Richard-V31/16_Store_Enrouleur/StoreEnrouleur_JGB37_DRV8876/DOC/1792562363564_image.png

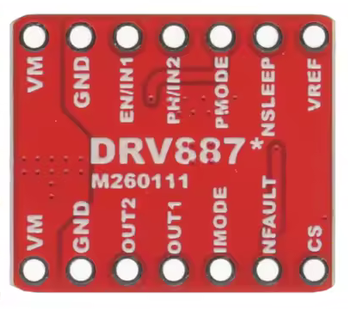
StoreEnrouleur_JGB37_DRV8876/DOC/1792562363564_image.png
