Richard-V31/16_Store_Enrouleur/Version_StoreEnrouleur_multi_ESP/Manuel_utilisation_Stores_v7.4.pdf

Stores enrouleurs v7.4 — Manuel d'utilisation de la page web | Page 1

# Manuel d'utilisation de la page web

Stores enrouleurs — programme v7.4

## 1. Ouvrir la page

Le téléphone ou l'ordinateur doit être connecté au Wi-Fi de la maison. Dans le navigateur, tapez l'adresse de la carte :

Adresse | Page
http://store1.local | Page de la carte « store1 » : ses stores, sa calibration, ses réglages
http://store1.local/tous | Tous les stores de toutes les cartes, sur une seule page
http://store1.local/info | Informations et compteurs de la carte

Remplacez store1 par le nom de votre carte. Si l'adresse en .local ne s'ouvre pas (cas fréquent sous Android), utilisez l'adresse IP de la carte, par exemple http://192.168.1.51. Elle est indiquée sur la page Informations.

Créer une icône sur le téléphone

Ouvrez la page voulue, puis dans le menu du navigateur choisissez « Ajouter à l'écran d'accueil » (Safari : bouton Partager > « Sur l'écran d'accueil »). Le raccourci prend le nom et la couleur de la carte. Conseil : une icône pour la page /tous (usage quotidien), et une par carte pour les réglages.

## 2. La page d'une carte

La page se met à jour seule deux fois par seconde : position, état et barre de progression suivent le store en direct. Sa présentation dépend de la carte : un moteur, deux moteurs indépendants, ou deux moteurs synchronisés.

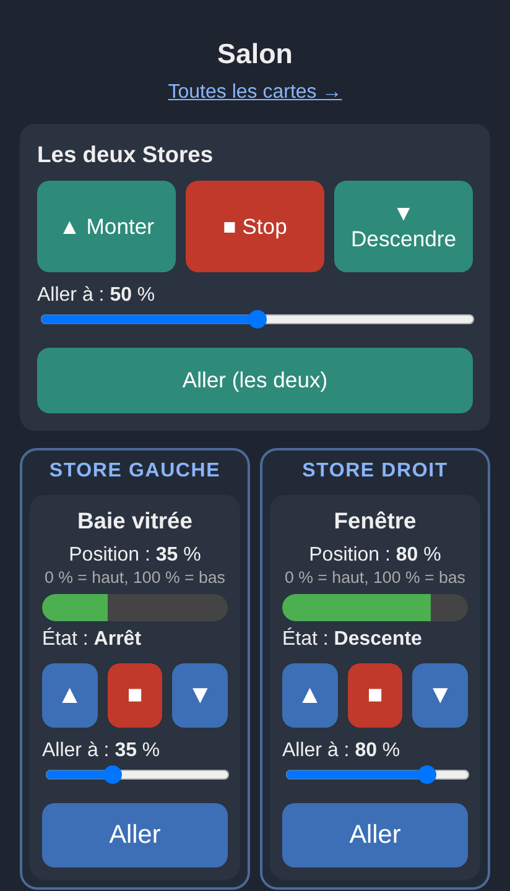
[picture p28: figure]

Stores enrouleurs v7.4 — Manuel d'utilisation de la page web | Page 2

Page d'une carte à deux moteurs indépendants

### 2.1 Le cadre d'un store

Élément | Rôle
Titre du cadre | Emplacement du store (Store Gauche, Store Droit…)
Nom | Nom du store, modifiable dans « Réglage Moteurs »
Position | 0 % = tout en haut, 100 % = tout en bas ; « -- » si le store n'est pas calibré
Barre verte | La même position, en image
État | Arrêt, Montée, Descente — avec « non calibré » ou « calibration en cours » si besoin
▲ (Monter) | Monte jusqu'à ce qu'on appuie sur Stop ou jusqu'à la butée haute
■ (Stop) | Arrêt immédiat
▼ (Descendre) | Descend jusqu'à Stop ou jusqu'à la butée basse
Curseur « Aller à » | Choisit une position, de 0 à 100 %
Aller | Envoie le store à la position du curseur, puis il s'arrête seul

Avec deux moteurs, les deux cadres sont côte à côte et les boutons n'affichent que les symboles ▲ ■ ▼. Avec un seul moteur, le cadre prend toute la largeur et les boutons portent aussi leur texte.

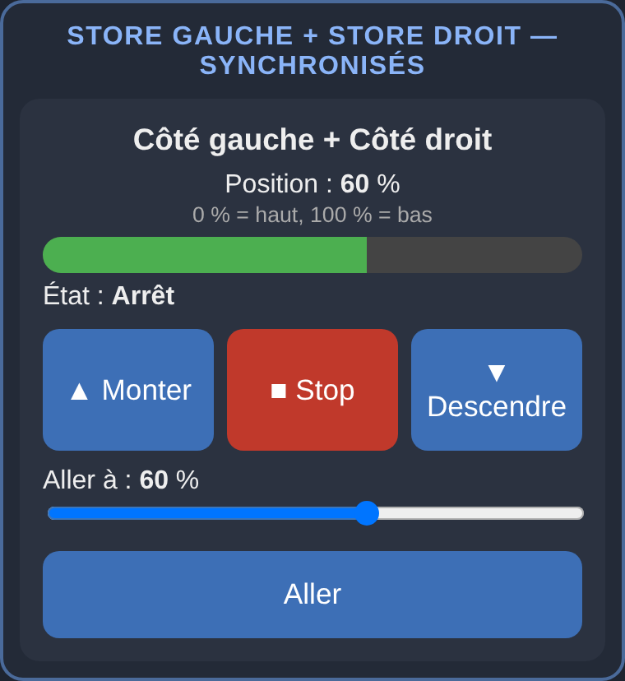
[picture p29: figure]
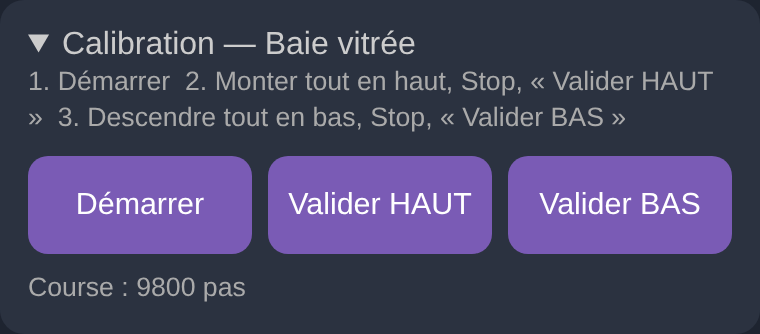
[picture p30: figure]

Stores enrouleurs v7.4 — Manuel d'utilisation de la page web | Page 3

Le moteur démarre doucement et ralentit avant d'arriver : c'est normal. Seul le bouton Stop arrête net.

### 2.2 La carte « Les deux Stores »

Présente seulement avec deux moteurs indépendants. Ses boutons ▲ Monter, ■ Stop, ▼ Descendre et « Aller (les deux) » agissent sur les deux stores à la fois. Si un store refuse (par exemple parce qu'il n'est pas calibré), l'autre obéit quand même et le motif s'affiche en bas de page.

### 2.3 Mode synchronisé

Quand un seul store est entraîné par deux moteurs (un de chaque côté), la page n'affiche qu'un seul cadre, intitulé « … + … — synchronisés ». Les boutons font tourner les deux moteurs ensemble. Le choix du mode est expliqué au chapitre 4.

Mode synchronisé : un seul cadre pour les deux moteurs

## 3. Calibration

La calibration apprend à la carte où sont le haut et le bas du store. Elle est obligatoire avant toute utilisation : sans elle, Monter, Descendre et Aller sont refusés. Elle est conservée après une coupure de courant.

Ouvrez la rubrique « Calibration — nom du store » (un clic sur son titre la déplie). En mode synchronisé, il n'y en a qu'une, marquée « (commune) ».

Rubrique Calibration dépliée

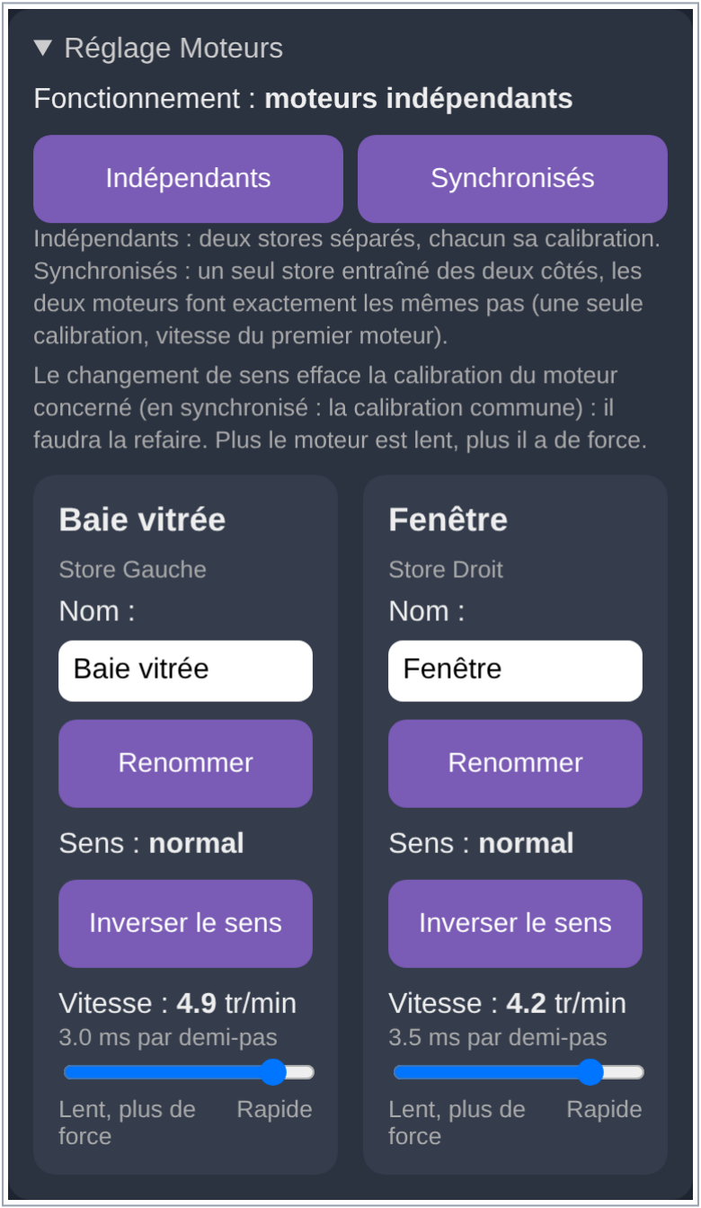
[picture p31: figure]

Stores enrouleurs v7.4 — Manuel d'utilisation de la page web | Page 4
1. Cliquez sur Démarrer. Les butées sont désactivées : le store peut aller partout. Restez attentif.
2. Appuyez sur ▲ pour monter le store. Arrêtez-le avec ■ exactement à la position haute voulue (vous pouvez corriger par petits coups de ▲ / ▼).
3. Cliquez sur Valider HAUT. L'état indique « calibration en cours (haut validé) ».
4. Appuyez sur ▼ pour descendre. Arrêtez-le avec ■ exactement à la position basse voulue.
5. Cliquez sur Valider BAS. La calibration est terminée : l'état revient à « Arrêt », la position affiche 100 % et la ligne « Course » indique le nombre de pas mesuré.

Attention. Pendant la calibration, le moteur ne s'arrête que sur Stop : ne le laissez pas forcer contre une butée mécanique. Les validations sont refusées tant que le moteur tourne.

Quand refaire la calibration ? Après une inversion du sens, après le passage en mode synchronisé, ou si le store s'arrête trop haut ou trop bas (store forcé à la main, glissement).

## 4. Réglage Moteurs

Cliquez sur « Réglage Moteurs » pour déplier la rubrique. Il y a une carte par moteur, plus le choix du mode quand la carte a deux moteurs.

Rubrique Réglage Moteurs dépliée

### 4.1 Nom du store

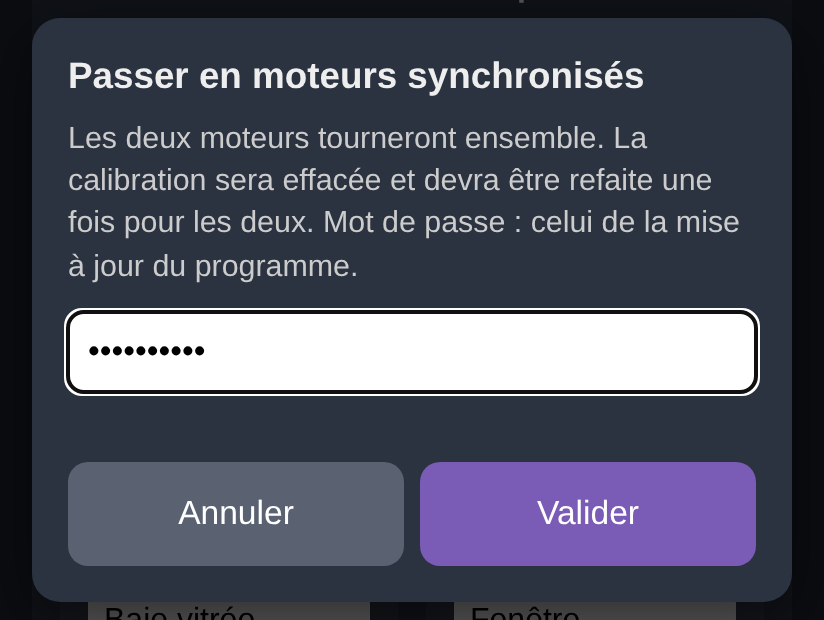
[picture p32: figure]

Stores enrouleurs v7.4 — Manuel d'utilisation de la page web | Page 5

Tapez le nouveau nom dans le champ Nom, puis cliquez sur Renommer. 32 caractères au maximum ; les caractères " \ < > & sont retirés. Un nom vide redonne le nom d'origine. Le nouveau nom apparaît partout, y compris sur la page /tous.

### 4.2 Sens de rotation

Si ▲ fait descendre le store, cliquez sur Inverser le sens et confirmez. La calibration de ce store est effacée (en synchronisé : la calibration commune) : refaites-la ensuite. En synchronisé, chaque moteur a son propre sens : réglez-les pour que les deux côtés tournent dans le même sens.

### 4.3 Vitesse

Le curseur va de « Lent, plus de force » à « Rapide ». Au-dessus s'affichent la vitesse en tours par minute (environ 1,5 à 7,3 tr/min) et la durée d'un demi-pas. La nouvelle vitesse est envoyée quand vous relâchez le curseur, et s'applique même pendant un mouvement. Si un moteur peine ou vibre sans tourner, ralentissez-le : un moteur lent a plus de force.

En synchronisé, seule la vitesse du premier moteur compte ; la carte du second l'indique.

### 4.4 Fonctionnement : indépendants ou synchronisés

Mode | Usage
Indépendants | Deux stores séparés : chacun sa position, sa calibration et sa vitesse
Synchronisés | Un seul store tiré des deux côtés : les deux moteurs font exactement les mêmes pas
1. Cliquez sur le mode voulu (Indépendants ou Synchronisés).
2. Une fenêtre s'ouvre et explique la conséquence. Tapez le mot de passe de mise à jour du programme.
3. Cliquez sur Valider (ou touche Entrée). Annuler ou la touche Échap ferment la fenêtre sans rien changer.

Fenêtre de changement de mode

Si le mot de passe est faux, la fenêtre reste ouverte avec le message « Mot de passe incorrect ». Le mode choisi est conservé après une coupure de courant.

- Passage en synchronisé : la calibration est effacée ; faites une calibration (commune) une fois.
- Retour en indépendants : chaque moteur garde la calibration actuelle.

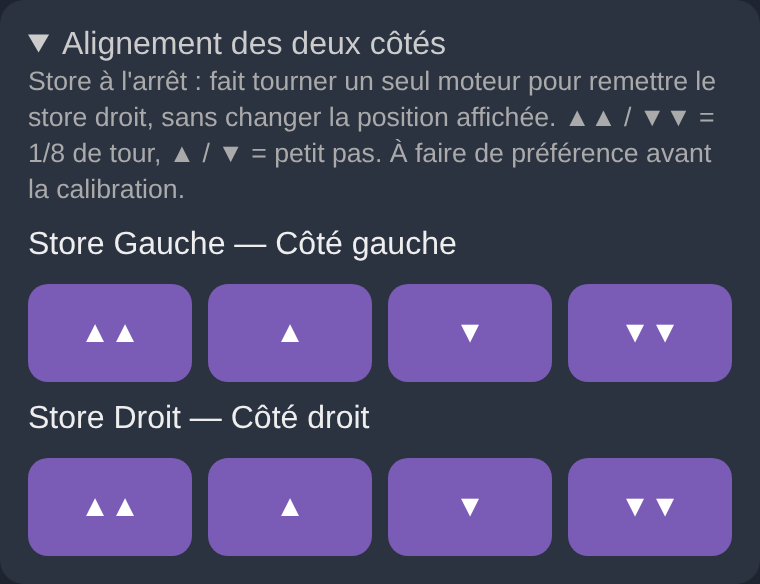
[picture p33: figure]

Stores enrouleurs v7.4 — Manuel d'utilisation de la page web | Page 6

### 4.5 Alignement des deux côtés (synchronisé)

Si le store pend de travers, ouvrez la rubrique « Alignement des deux côtés ». Store à l'arrêt, chaque bouton fait tourner un seul moteur, lentement, sans changer la position affichée :

Bouton | Déplacement de ce côté
▲▲ / ▼▼ | 1/8 de tour vers le haut / le bas
▲ / ▼ | Petit pas (1/64 de tour)

Rubrique Alignement (mode synchronisé)

Les appuis s'additionnent (un tour au maximum). L'état affiche « Alignement en cours » pendant le mouvement. Faites l'alignement de préférence avant la calibration. Tout mouvement du store annule un alignement en attente.

## 5. La page « Toutes les cartes » (/tous)

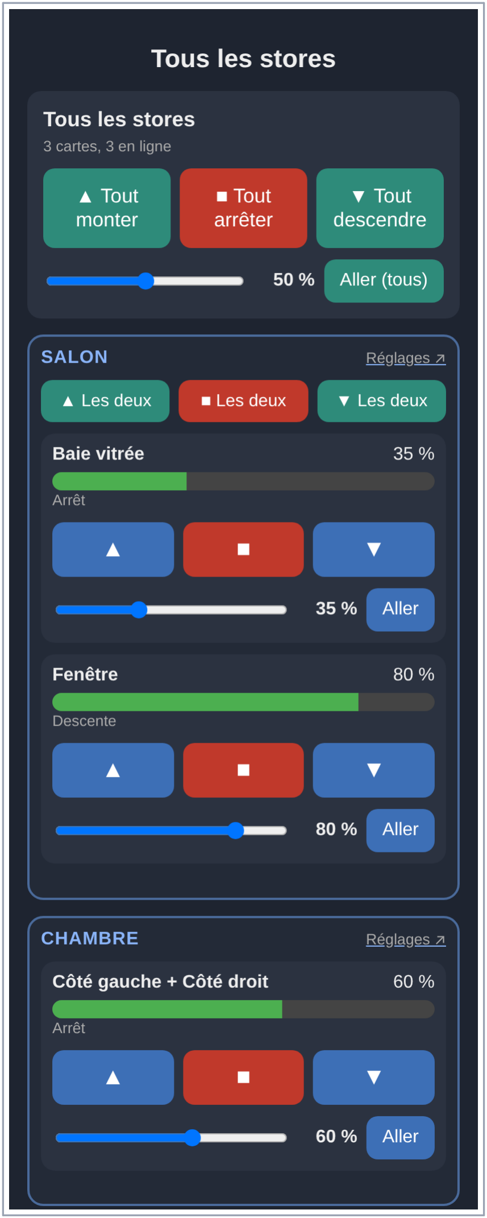
[picture p34: figure]

Stores enrouleurs v7.4 — Manuel d'utilisation de la page web | Page 7

Page « Toutes les cartes » avec trois cartes (Salon, Chambre en synchronisé, Bureau non calibré)

Accessible depuis n'importe quelle carte (lien « Toutes les cartes → » en haut de sa page). Elle réunit tous les stores de la maison. Les autres cartes apparaissent toutes seules dans les 30 secondes ; le compteur en haut indique combien de cartes sont trouvées et combien sont en ligne.

### 5.1 Tous les stores

Bouton | Effet
▲ Tout monter | Monte tous les stores de toutes les cartes
■ Tout arrêter | Arrête tout (envoyé aussi aux cartes qui ne répondent plus)
▼ Tout descendre | Descend tous les stores
Curseur + Aller (tous) | Envoie tous les stores à la même position

### 5.2 Le cadre de chaque carte

- Titre de la carte (son nom de pièce) et lien Réglages ↗, qui ouvre la page de cette carte pour la calibration et les réglages.
- Boutons « Les deux » (▲ ■ ▼) si la carte a deux stores indépendants.
- Pour chaque store : nom, position, barre, état, boutons ▲ ■ ▼, curseur et bouton Aller.
- Un refus éventuel (store non calibré…) s'affiche en orange sous le cadre.

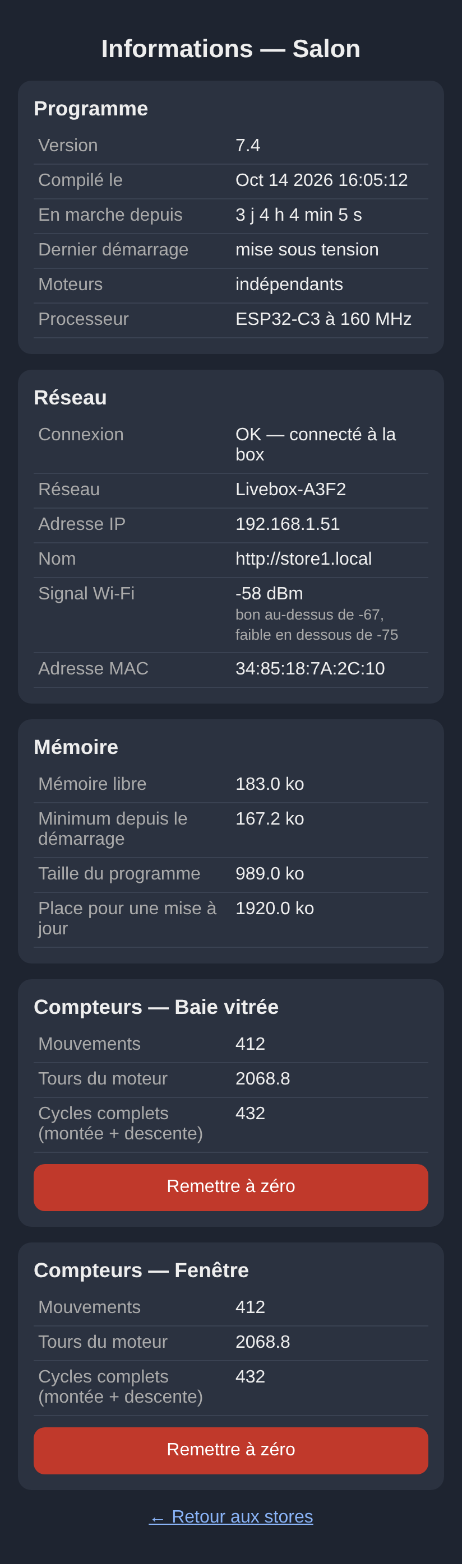
[picture p35: figure]

Stores enrouleurs v7.4 — Manuel d'utilisation de la page web | Page 8
- Une carte qui ne répond plus devient grisée, avec « Carte injoignable ». Elle redevient normale dès qu'elle répond.

La page /tous ne permet ni la calibration ni les réglages : utilisez le lien Réglages ↗.

## 6. Page Informations (/info)

Accessible par le lien Informations en bas des pages. Rafraîchie toutes les 2 secondes.

Page Informations

Carte | Contenu
Programme | Version, date de compilation, durée de fonctionnement, cause du dernier démarrage, mode des moteurs, processeur
Réseau | État de la connexion, réseau, adresse IP, nom .local, force du signal Wi-Fi, adresse MAC
Mémoire | Mémoire libre, minimum atteint, taille du programme, place pour une mise à jour
Compteurs | Par store : mouvements, tours du moteur, cycles complets (montée + descente)

Signal Wi-Fi : bon au-dessus de −67 dBm, faible en dessous de −75 dBm. Le bouton Remettre à zéro (avec confirmation) remet les compteurs d'un store à zéro, par exemple après un changement de moteur.

## 7. Mise à jour du programme (/update)

Stores enrouleurs v7.4 — Manuel d'utilisation de la page web | Page 9
1. Dans l'Arduino IDE : Croquis > Exporter les binaires compilés.
2. Ouvrez la page Mise à jour du programme (lien en bas de la page de la carte).
3. Tapez le mot de passe OTA, choisissez le fichier .ino.bin du croquis (pas « merged », pas « bootloader »), puis cliquez sur Envoyer.
4. La barre montre l'envoi. À la fin, la carte redémarre et la page principale revient seule au bout de 10 secondes.

Les moteurs sont arrêtés pendant la mise à jour ; positions, calibration et réglages sont conservés. Envoyez toujours un fichier compilé pour le même modèle de carte (C3 ou S3).

## 8. Mode secours (sans la box)

Si la carte ne trouve pas la box à son démarrage (box éteinte, coupure de courant), elle crée son propre réseau Wi-Fi, par exemple « Store1-Secours ».

1. Sur le téléphone, connectez-vous à ce réseau (mot de passe : celui du réseau de secours).
2. Ouvrez http://192.168.5.1 : la page de la carte fonctionne normalement.

Toutes les 2 minutes, la carte essaie de retrouver la box (sauf pendant qu'un téléphone est connecté à son réseau de secours) et y retourne seule dès qu'elle répond. En mode secours, la page /tous ne montre que cette carte.

## 9. Messages

Les messages apparaissent en bas de la page (en orange sous le cadre de la carte sur /tous).

Message | Signification | Que faire
non calibré : lancez d'abord la calibration | Store jamais calibré | Faire la calibration (chapitre 3)
non calibré ou calibration en cours | « Aller » impossible pour l'instant | Terminer la calibration
cliquez d'abord sur « Démarrer » | Validation sans calibration commencée | Cliquer sur Démarrer
validez d'abord la position haute | « Valider BAS » trop tôt | Valider le haut d'abord
arrêtez le moteur avant de valider | Le moteur tourne | Appuyer sur Stop, puis valider
descendez le store avant de valider le bas | Position basse = position haute | Descendre le store
arrêtez le store avant d'aligner | Alignement pendant un mouvement | Stop, puis aligner
Mise à jour en cours, patientez | Programme en cours d'écriture | Attendre le redémarrage
Mot de passe incorrect : mode inchangé | Changement de mode refusé | Mot de passe de mise à jour
Carte injoignable | La carte ne répond pas | Vérifier son alimentation et le Wi-Fi
Moteurs synchronisés : faites la calibration… | Mode changé | Faire la calibration commune
… : sens inversé, refaites sa calibration | Sens changé | Refaire la calibration

Stores enrouleurs v7.4 — Manuel d'utilisation de la page web | Page 10

## 10. Questions fréquentes

Le store s'arrête un peu avant ou après le bon endroit. La position est calculée en comptant les pas ; un glissement ou une manœuvre à la main la décale. Refaites la calibration.

Une coupure de courant pendant un mouvement ? La position est enregistrée pendant le mouvement : au redémarrage, l'écart reste faible. Vérifiez par un aller jusqu'en haut ; recalibrez si le décalage gêne.

Deux personnes commandent en même temps ? Possible : la dernière commande reçue l'emporte. Toutes les pages ouvertes affichent le même état.

Une carte manque sur la page /tous. Attendez 30 secondes et rechargez la page. Si elle n'apparaît toujours pas, ouvrez-la directement par son adresse pour vérifier qu'elle fonctionne, puis voyez la notice technique (adresses fixes FIXED_PEERS).
