Richard-V31/16_Store_Enrouleur/PCB/BOTTOM.JPG

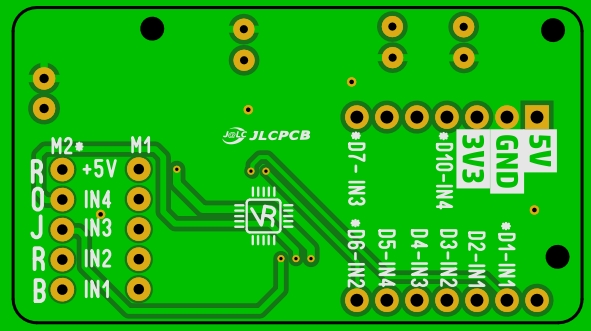
PCB/BOTTOM.JPG
