Richard-V31/16_Store_Enrouleur/PCB/PCB.JPG

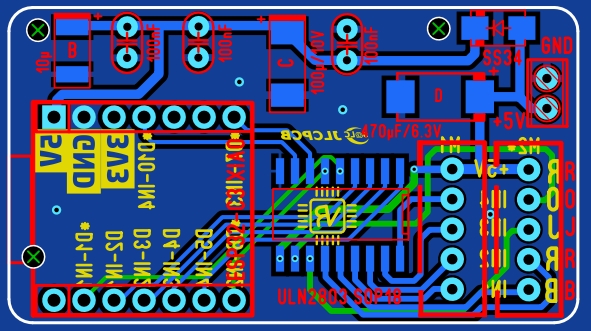
PCB/PCB.JPG
