Richard-V31/16_Store_Enrouleur/PCB/TOP.JPG

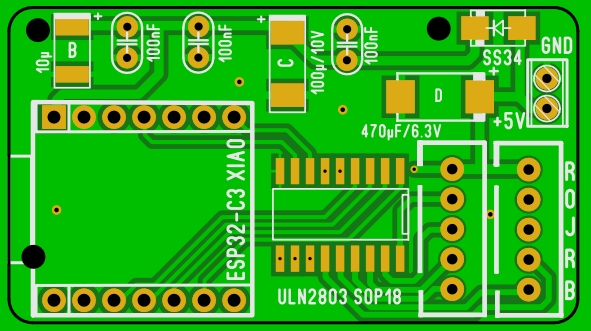
PCB/TOP.JPG
