Richard-V31/16_Store_Enrouleur/PCB/VERSION_DOUBLE/BOTTOM DOUBLE.JPG

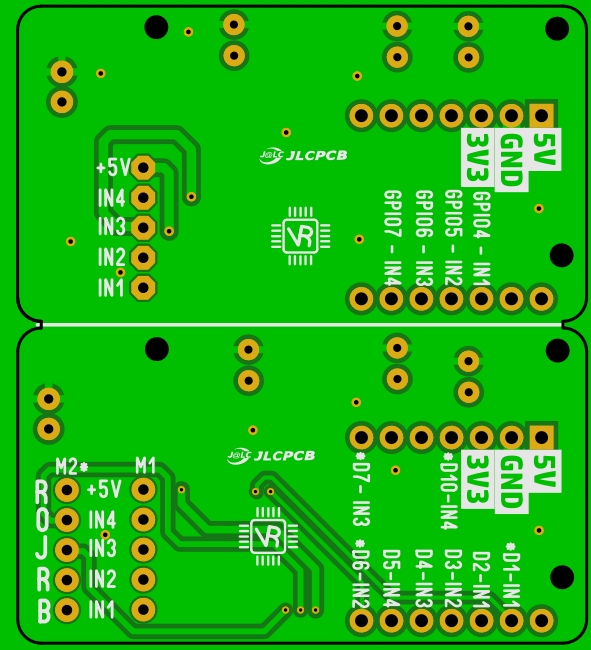
PCB/VERSION_DOUBLE/BOTTOM DOUBLE.JPG
