Richard-V31/16_Store_Enrouleur/PCB/VERSION_DOUBLE/PCB DOUBLE.JPG

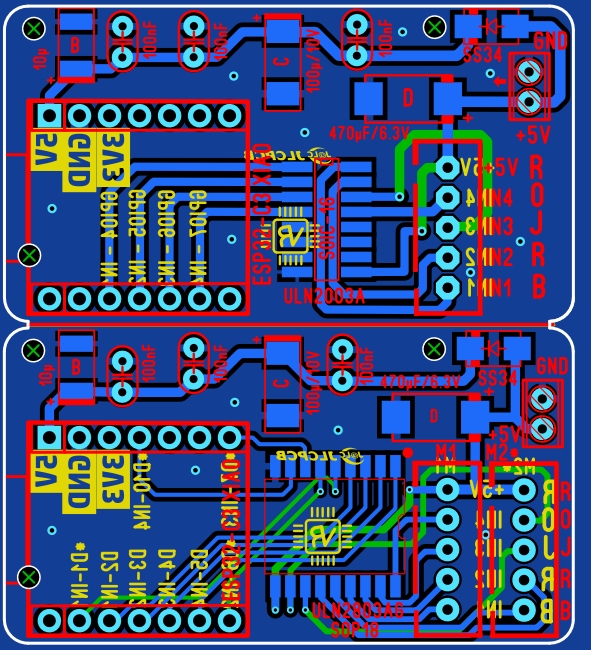
PCB/VERSION_DOUBLE/PCB DOUBLE.JPG
