Richard-V31/16_Store_Enrouleur/StoreEnrouleur_JGB37_DRV8876/DOC/DRV8876.jpg

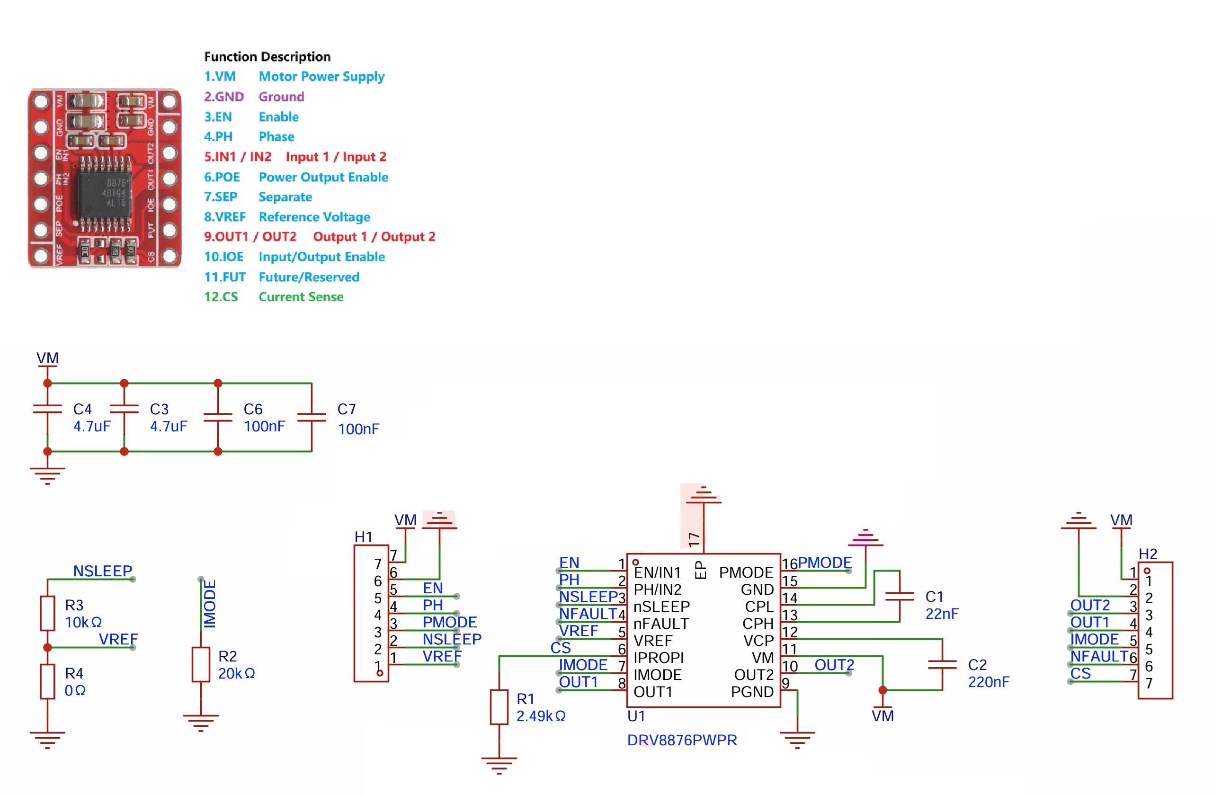
StoreEnrouleur_JGB37_DRV8876/DOC/DRV8876.jpg
