Richard-V31/16_Store_Enrouleur/StoreEnrouleur_JGB37_DRV8876/DOC/Moteur/JGB37 520  2.png

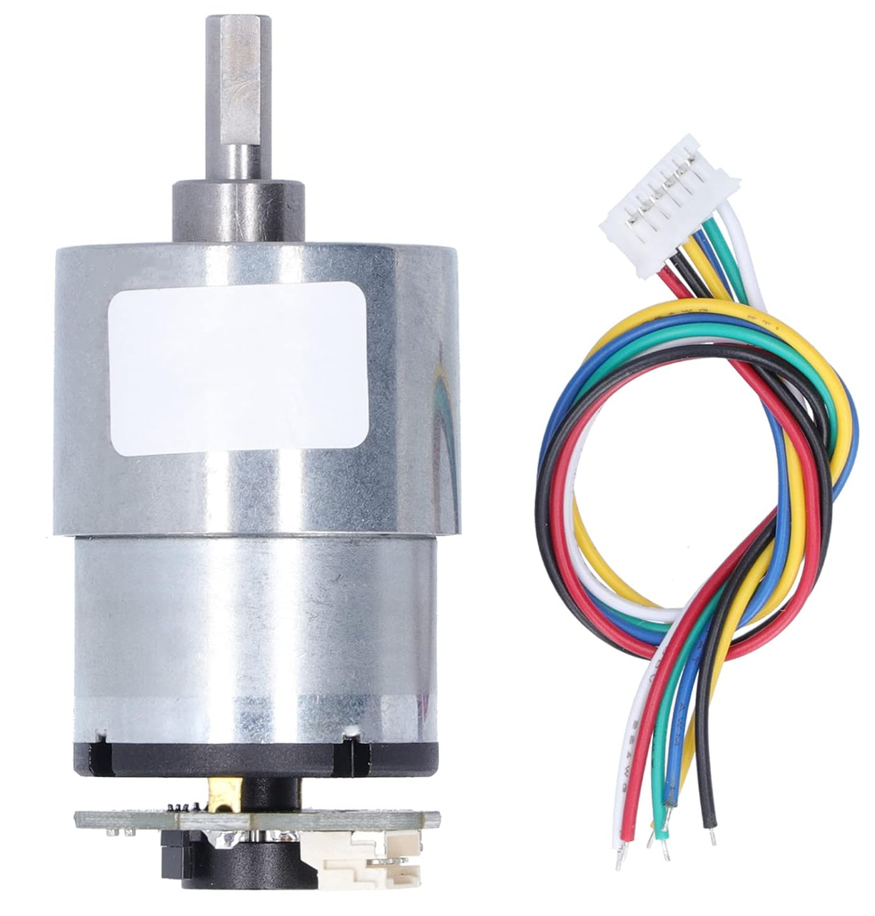
StoreEnrouleur_JGB37_DRV8876/DOC/Moteur/JGB37 520 2.png
