Richard-V31/16_Store_Enrouleur/Version_StoreEnrouleur_multi_ESP/Capture ecran.png

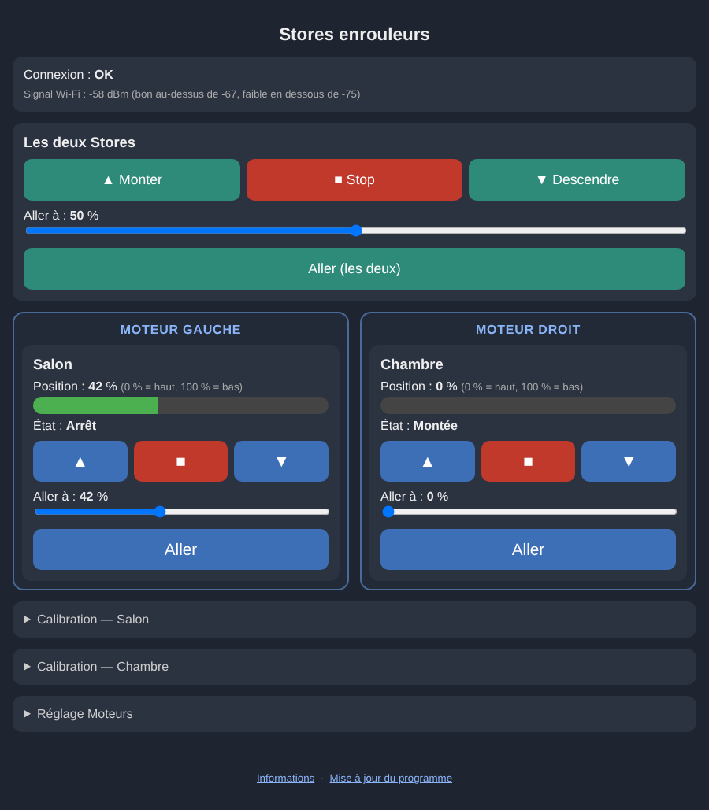
Version_StoreEnrouleur_multi_ESP/Capture ecran.png
