Richard-V31/16_Store_Enrouleur/StoreEnrouleur_JGB37_DRV8876/DOC/Choix_vitesse_JGB37-520.xlsx

Choix de la vitesse du motoréducteur JGB37-520 12 V — store enrouleur
Cellules jaunes à texte bleu = hypothèses à modifier ; le reste se recalcule.
Hypothèses
Diamètre du tube (mm) | 35 | Tube de store (valeur de la fiche technique)
Hauteur de toile à enrouler (mm) | 1500 | À adapter à ton store
Couple nécessaire au store (kg·cm) | 1.6 | Fiche technique : 1,58 kg·cm pour un store de 900 g sur tube de 35 mm
Couple nominal de référence (kg·cm) | 8.4 | Fiche technique : JGB37-520 12 V, réducteur 1:270, en charge nominale
Rapport de référence (1:x) | 270 | Rapport correspondant au couple de référence
Impulsions encodeur par tour moteur | 11 | Fiche technique : encodeur à effet Hall, 11 impulsions/tour
Temps de course maximal acceptable (s) | 35 | Au-delà : jugé trop lent
Marge de couple conseillée (×) | 4 | Couple nominal / couple nécessaire pour « meilleur compromis »
Marge de couple minimale (×) | 2.5 | En dessous : à éviter
Comparaison des versions
Vitesse (tr/min) | Réducteur (1:x) | Vitesse de la toile (mm/s) | Temps pour la hauteur (s) | Couple nominal estimé (kg·cm) | Marge de couple (×) | Impulsions par tour de tube | Avis
20 | 1:506.0 | 36.65191429 | 40.9 | 15.7 | 9.8× | 22264 | Trop lent, inutile
37 | 1:270.0 | 67.80604144 | 22.1 | 8.4 | 5.2× | 11880 | Le meilleur compromis
60 | 1:168.0 | 109.9557429 | 13.6 | 5.2 | 3.3× | 7392 | Possible si tu veux plus rapide
111 | 1:90.0 | 203.4181243 | 7.4 | 2.8 | 1.8× | 3960 | À éviter : marge trop faible
178 | 1:56.0 | 326.2020372 | 4.6 | 1.7 | 1.1× | 2464 | À éviter : marge trop faible
333 | 1:30.0 | 610.254373 | 2.5 | 0.9 | 0.6× | 1320 | À éviter : marge trop faible
530 | 1:19.0 | 971.2757287 | 1.5 | 0.6 | 0.4× | 836 | À éviter : marge trop faible
1000 | 1:10.0 | 1832.595715 | 0.8 | 0.3 | 0.2× | 440 | À éviter : marge trop faible
1590 | 1:6.3 | 2913.827186 | 0.5 | 0.2 | 0.1× | 277.2 | À éviter : marge trop faible
Notes
• Couple estimé proportionnellement au rapport de réduction, à partir de 8,4 kg·cm au 1:270 (fiche technique). Le rendement réel du réducteur et sa limite mécanique ne sont pas pris en compte : aux grands rapports (1:506), le couple réel est plafonné par le réducteur.
• Le couple nécessaire augmente quand la toile s'enroule (diamètre qui grossit), avec le frottement des coulisses et l'usure : d'où une marge conseillée d'environ 4×.
• Les grands rapports (1:270, 1:168) sont presque irréversibles : hors tension, le poids de la toile ne fait pas tourner le moteur et la position mémorisée reste juste. En dessous de 1:90, le store risque de glisser après une coupure.
• Avec la limitation de courant du DRV8876 (≈ 1,3 A), un moteur moins démultiplié se rapproche plus vite de la limite pour la même charge.
• Programme v6 : aucune modification quelle que soit la vitesse ; la course est mesurée à la calibration.
