Richard-V31/16_Store_Enrouleur/STL/BlindGear_V5_27mm_PCBWay Community.stl

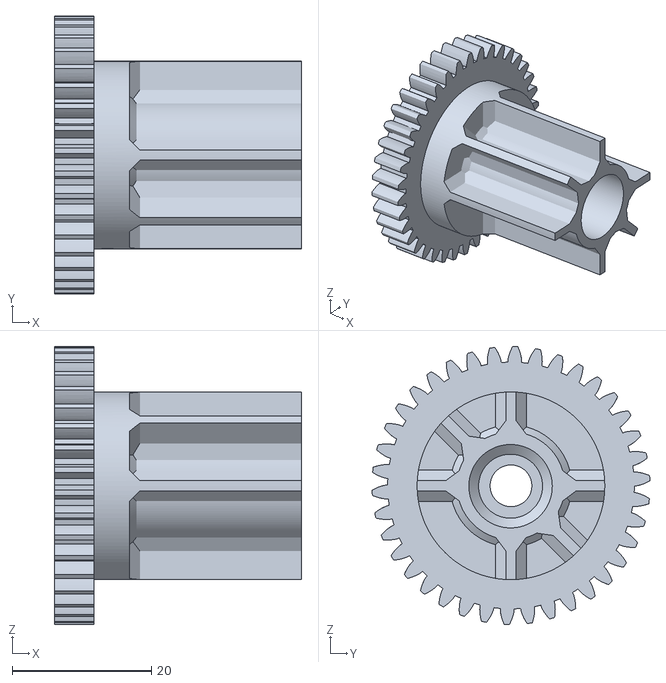
[picture p58: CAD file, 2026-10-30]
STL/BlindGear_V5_27mm_PCBWay Community.stl
35.6 x 40.0 x 40.0
