Richard-V31/16_Store_Enrouleur/STL/Fusion360/Pignon.stl

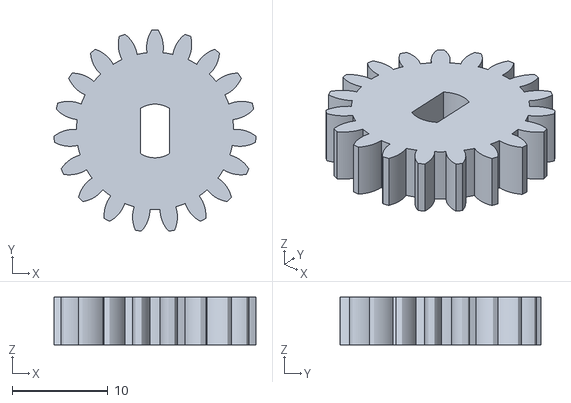
[picture p59: CAD file, 2026-10-31]
STL/Fusion360/Pignon.stl
21.1 x 21.0 x 5.00
