Richard-V31/16_Store_Enrouleur/STL/Circuit_Encloser_V3_PCBWay Community.stl

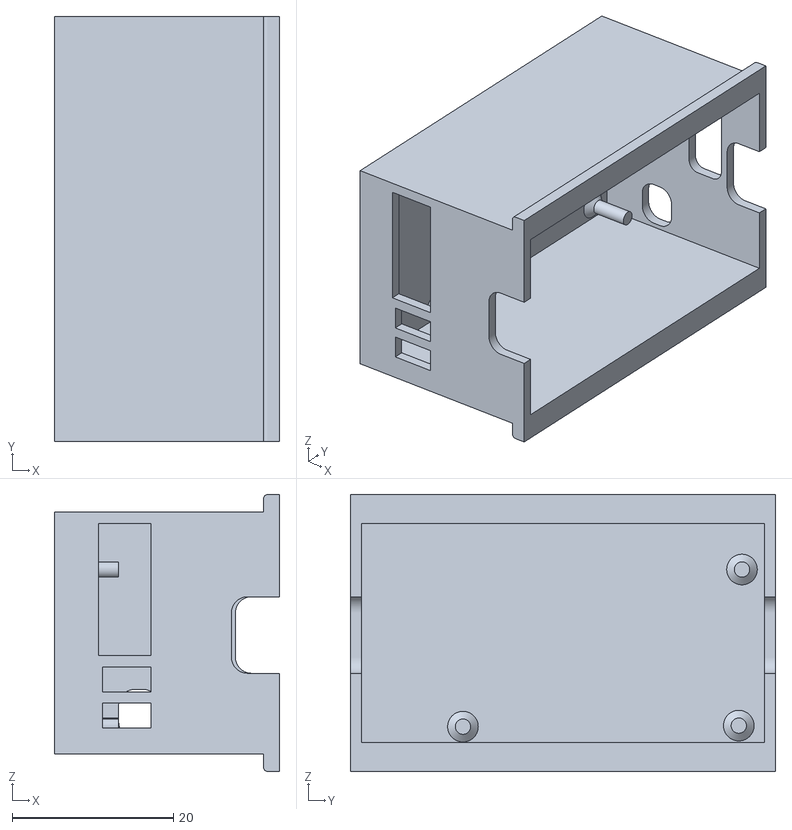
[picture p60: CAD file, 2026-10-30]
STL/Circuit_Encloser_V3_PCBWay Community.stl
28.0 x 52.8 x 34.4
