Richard-V31/16_Store_Enrouleur/STL/Fusion360/Roue_Store.stl

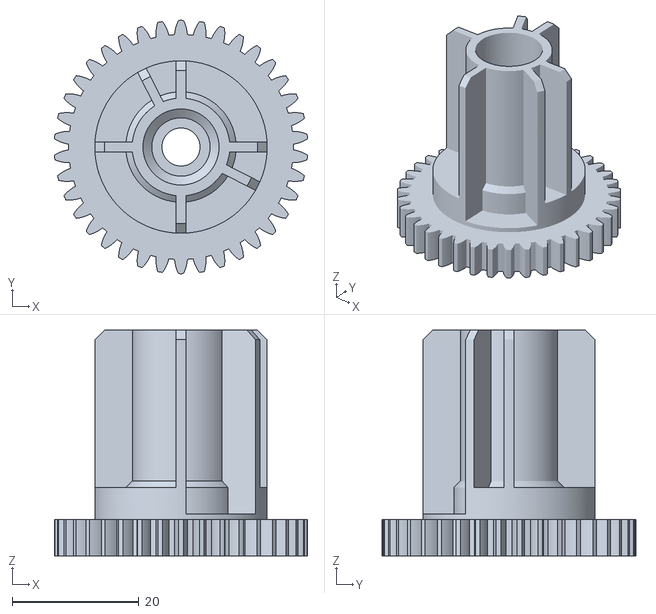
[picture p61: CAD file, 2026-10-31]
STL/Fusion360/Roue_Store.stl
39.9 x 40.0 x 35.6
