Richard-V31/16_Store_Enrouleur/STL/GearEncloser_V2_PCBWay Community.stl

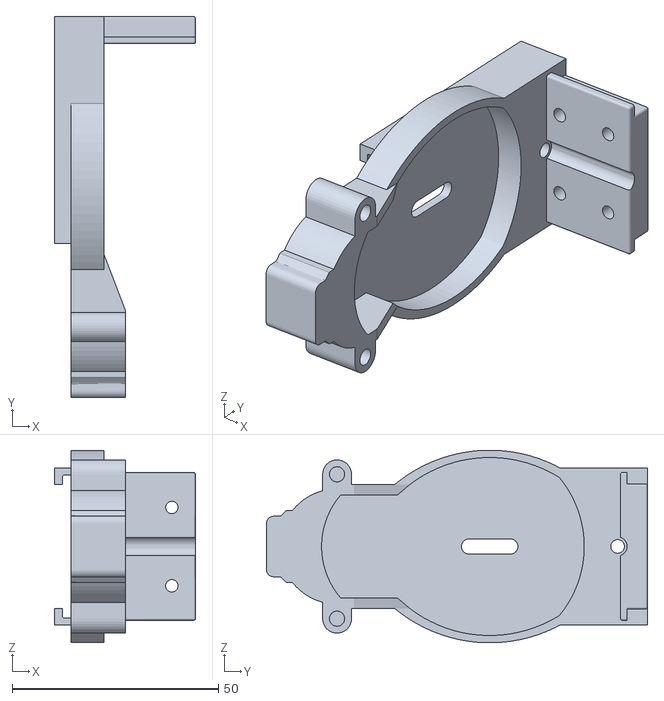
[picture p62: CAD file, 2026-10-30]
STL/GearEncloser_V2_PCBWay Community.stl
34.2 x 92.3 x 46.6
