Richard-V31/16_Store_Enrouleur/STL/BearingHolder_V5_PCBWay Community.stl

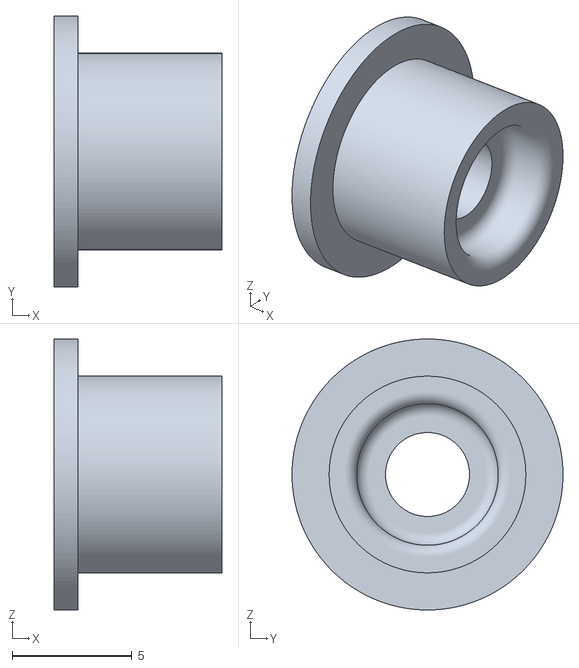
[picture p63: CAD file, 2026-10-30]
STL/BearingHolder_V5_PCBWay Community.stl
7.00 x 11.3 x 11.3
