Richard-V31/16_Store_Enrouleur/STL/28BYJ_48_Cover_V1_PCBWay Community.stl

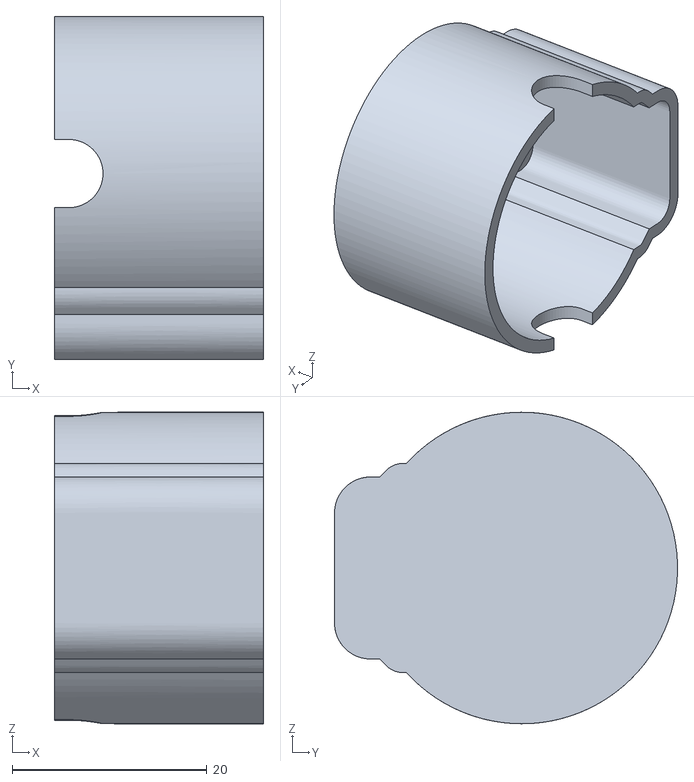
[picture p64: CAD file, 2026-10-30]
STL/28BYJ_48_Cover_V1_PCBWay Community.stl
21.5 x 35.2 x 32.0
