Richard-V31/16_Store_Enrouleur/(list of files, cad)

Other CAD files:
STL/28BYJ-48_Gear_V1_PCBWay Community.stl
STL/Fusion360/Pignon.f3d
STL/Fusion360/Roue_Store_D27 et pignon.f3d
STL/Fusion360/Roue_Store_D27.f3d
