Richard-V31/16_Store_Enrouleur/Version_StoreEnrouleur_multi_ESP/Installation_pour_3_cartes_stores_v7.4.pdf

Stores enrouleurs v7.4 — installation de 3 cartes | Page 1

# Installer 3 cartes ESP32 — stores enrouleurs v7.4

Programme StoreEnrouleur_Web_XIAO_C3_multi.ino · page commune « /tous »

Vous téléversez le même programme sur les 3 cartes. Avant chaque téléversement, vous changez seulement 4 lignes : 3 dans le .ino et 1 dans arduino_secrets.h. Rien d'autre à faire : les cartes se trouvent entre elles toutes seules.

### Les lignes à changer

Dans le .ino, section « WIFI » et section « APPARENCE » :

const char* HOSTNAME | = "store"; | // ← nom réseau, DOIT être différent sur chaque carte
const char* PAGE_TITLE = "Stores"; | // ← nom affiché (titre du cadre sur la page /tous)
const char* ICON_COLOR = "#3d6fb6"; | // ← couleur de l'icône sur le téléphone

Dans arduino_secrets.h :

#define SECRET_AP_SSID "Store-Secours" // ← réseau de secours, différent sur chaque carte

### Les valeurs pour vos 3 cartes

| Carte 1 | Carte 2 | Carte 3
HOSTNAME | "store1" | "store2" | "store3"
PAGE_TITLE | "Salon" | "Chambre" | "Bureau"
ICON_COLOR | "#3d6fb6" | "#2e8b7a" | "#b5653d"
SECRET_AP_SSID | "Store1-Secours" | "Store2-Secours" | "Store3-Secours"

Mettez vos propres noms de pièces dans PAGE_TITLE. SECRET_SSID, SECRET_PASS (votre box) et SECRET_OTA_PASS restent identiques sur les 3 cartes.

Facultatif, selon chaque carte :

- MOTOR2_ENABLED = false; si cette carte n'a qu'un seul moteur.
- MOT1_SIDE / MOT2_SIDE : le titre des cadres des moteurs sur la page de la carte.

### La marche à suivre

1. Mettez les valeurs de la carte 1, branchez-la en USB et téléversez.
2. Changez les 4 lignes pour la carte 2, branchez-la et téléversez.
3. Même chose pour la carte 3.
4. Sur le téléphone, ouvrez http://store1.local/tous. Après une trentaine de secondes, les 3 cartes apparaissent sur la même page.
5. Faites la calibration de chaque store depuis le lien « Réglages ↗ » de chaque cadre.
6. Sur la page /tous, faites « Ajouter à l'écran d'accueil » : une seule icône pour tous les stores de la maison.

Stores enrouleurs v7.4 — installation de 3 cartes | Page 2

### Si une carte n'apparaît pas sur /tous

Certaines box bloquent la recherche automatique. Dans ce cas :

1. Réservez une adresse IP fixe pour chaque carte dans la box. L'adresse MAC de chaque carte est sur sa page /info.
2. Sur chacune des 3 cartes, remplissez la même ligne avec ces adresses, puis téléversez de nouveau :

const char* FIXED_PEERS = "192.168.1.51,192.168.1.52,192.168.1.53";

Chaque carte reconnaît sa propre adresse dans la liste et l'ignore : la ligne peut donc être identique partout.

Les mises à jour suivantes peuvent se faire sans câble, par OTA. Gardez simplement les bonnes valeurs des 4 lignes pour la carte que vous mettez à jour.
