Richard-V31/16_Store_Enrouleur/STL/Fusion360/Dessins_techniques_engrenages_store.pdf

A

## VUE DE FACE

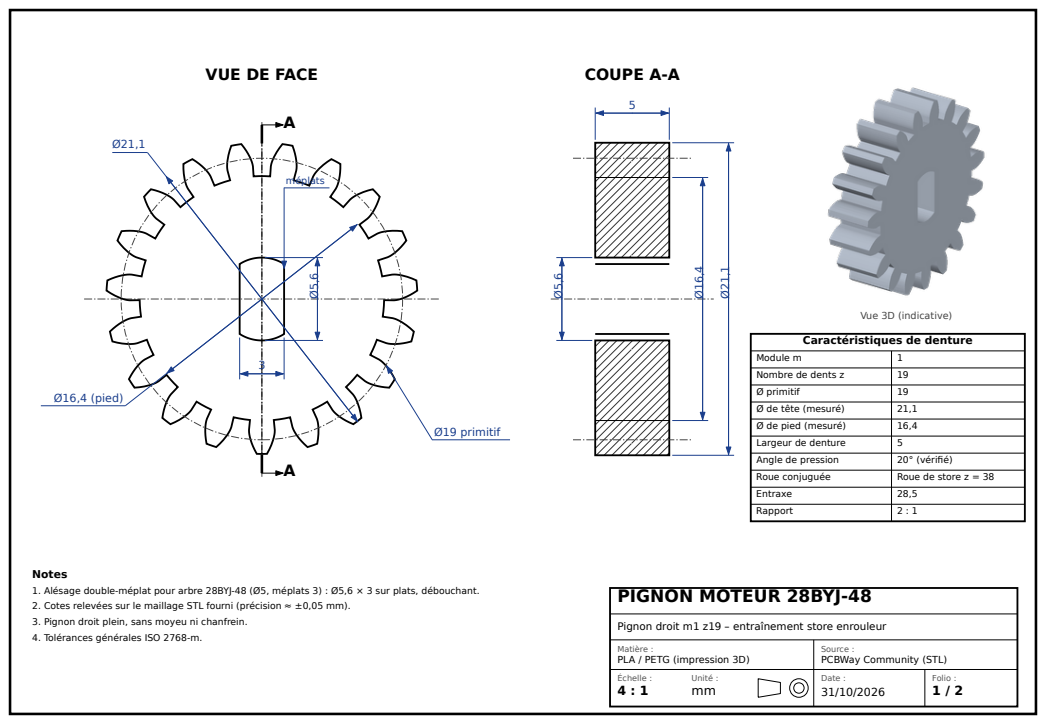
[picture p66: page 1]
Ø16,4 (pied); Ø19 primitif; méplats; COUPE A-A; Vue 3D (indicative); Module m; Nombre de dents z; Ø primitif; Ø de tête (mesuré); Ø de pied (mesuré); Largeur de denture; Angle de pression; 20° (vérifié); Roue conjuguée; Roue de store z = 38; Entraxe; Rapport; PIGNON MOTEUR 28BYJ-48; Échelle : 4 : 1; Unité : mm; Date : 31/10/2026; Folio : 1 / 2

Caractéristiques de denture

Notes
1. Alésage double-méplat pour arbre 28BYJ-48 (Ø5, méplats 3) : Ø5,6 × 3 sur plats, débouchant.
2. Cotes relevées sur le maillage STL fourni (précision ≈ ±0,05 mm).
3. Pignon droit plein, sans moyeu ni chanfrein.
4. Tolérances générales ISO 2768-m.

Pignon droit m1 z19 – entraînement store enrouleur

Matière :
PLA / PETG (impression 3D)

Source :
PCBWay Community (STL)

## VUE B

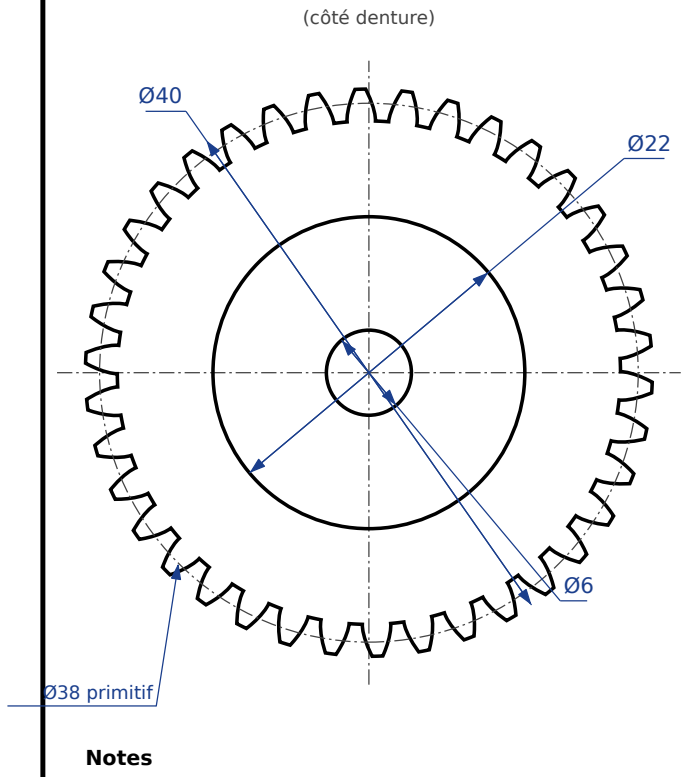
[picture p67: figure]
Ø38 primitif; (côté denture); Notes

1. Ailettes coupées longitudinalement : non hachurées (convention ISO).
2. Ø27 sur ailettes = Ø intérieur du tube de store.
3. Raccord âme/flasque ≈1×45° ; congés R≈1 en pied d'ailettes.
4. Cotes relevées sur le maillage STL fourni
(précision ≈ ±0,05 mm).
5. Vue C partielle : denture (arrière-plan) non représentée.
6. 6 ailettes ép. 1,5 : à 0°, 90°, 135°, 180°, 270° et 315°.

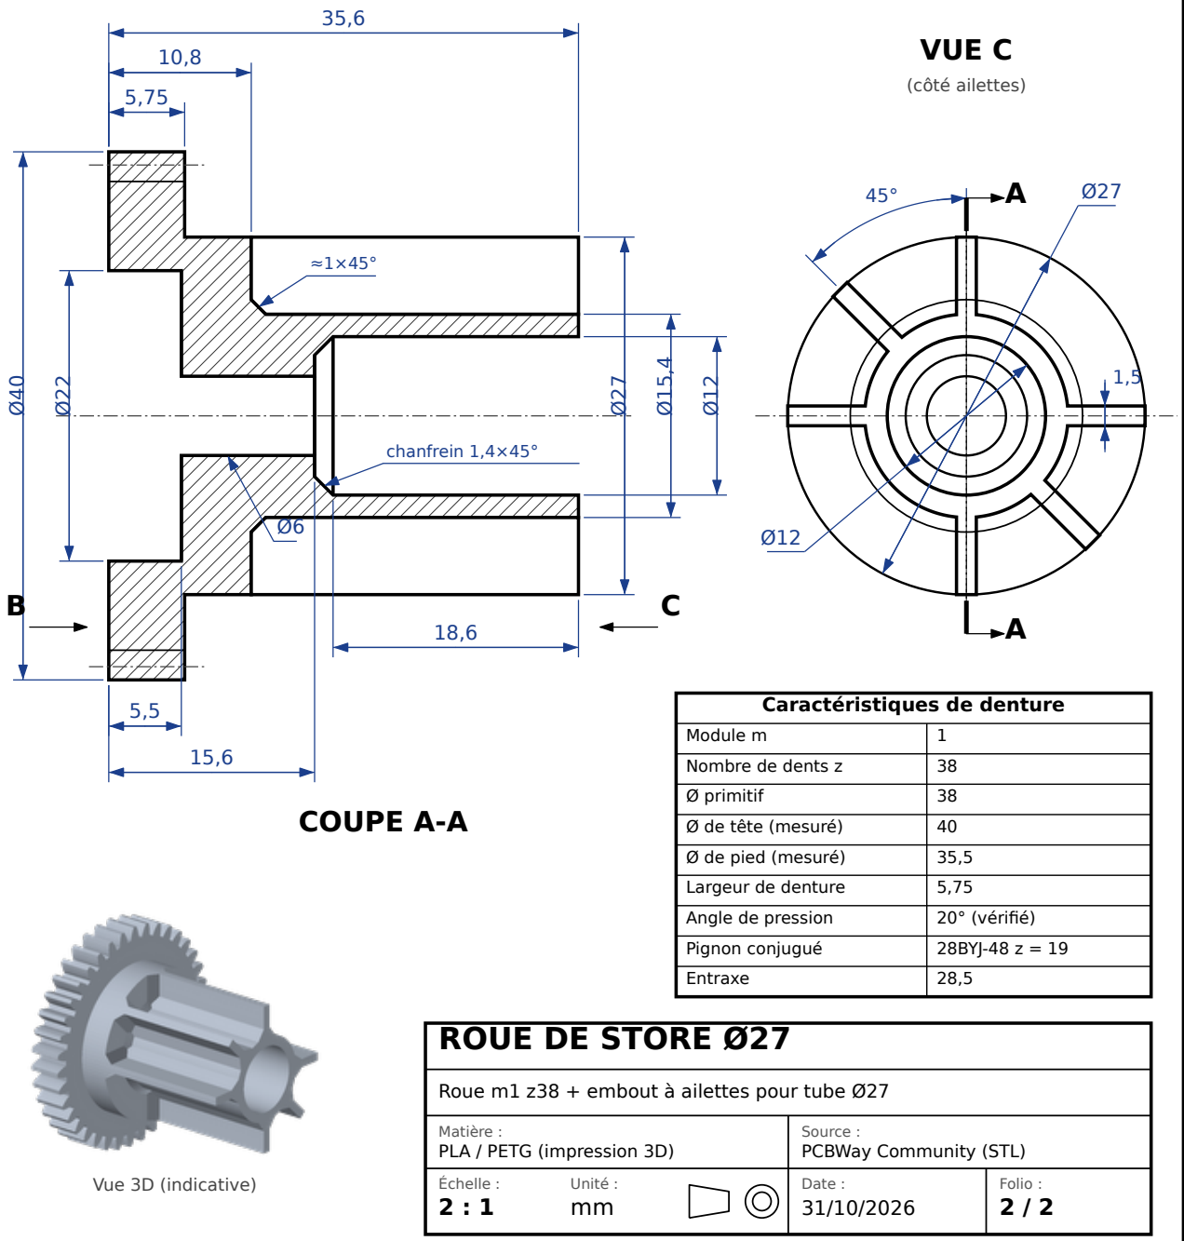
[picture p68: figure]
chanfrein 1,4×45°; COUPE A-A; VUE C; (côté ailettes); Vue 3D (indicative); Caractéristiques de denture; Module m; Nombre de dents z; Ø primitif; Ø de tête (mesuré); Ø de pied (mesuré); Largeur de denture; Angle de pression; 20° (vérifié); Pignon conjugué; 28BYJ-48 z = 19; Entraxe; Matière : PLA / PETG (impression 3D); Source : PCBWay Community (STL); Échelle : 2 : 1; Unité : mm; Date : 31/10/2026; Folio : 2 / 2

7. Tolérances générales ISO 2768-m. | ROUE DE STORE Ø27

Roue m1 z38 + embout à ailettes pour tube Ø27

Point important pour le montage : l’entraxe. L’entraxe théorique est de 28,5 mm, mais à cette valeur les dents s’engrènent sans aucun jeu. Avec des pièces imprimées en 3D, qui sont toujours un peu plus grosses que prévu, ça risque de forcer ou de gripper. Prévois plutôt 28,6 à 28,7 mm, ou un support de moteur avec trous oblongs pour

ajuster le jeu à la main.
