Richard-V31/16_Store_Enrouleur/(list of files, drawings)

Other design files:
PCB/Store ENROULEUR.lay6
