Richard-V31/16_Store_Enrouleur/StoreEnrouleur_JGB37_DRV8876/favicon.h

// Genere depuis favicon.png (2017 octets)
#pragma once
#include <Arduino.h>

const uint8_t favicon_png[] PROGMEM = {
  0x89, 0x50, 0x4E, 0x47, 0x0D, 0x0A, 0x1A, 0x0A, 0x00, 0x00, 0x00, 0x0D, 0x49, 0x48, 0x44, 0x52,
  0x00, 0x00, 0x00, 0xB4, 0x00, 0x00, 0x00, 0xB4, 0x08, 0x03, 0x00, 0x00, 0x00, 0x0A, 0x13, 0xF6,
  0x00, 0x00, 0x00, 0x00, 0xC0, 0x50, 0x4C, 0x54, 0x45, 0xEB, 0x9E, 0x9F, 0xE2, 0x63, 0x67, 0x55,
  0x5C, 0x69, 0x2A, 0x2E, 0x45, 0x2C, 0x32, 0x3B, 0x43, 0x9C, 0x76, 0x92, 0x91, 0x9E, 0x48, 0x30,
  0x3C, 0x2B, 0x32, 0x3F, 0xB3, 0x65, 0x6B, 0xAF, 0x78, 0x2C, 0x2A, 0x32, 0x3F, 0x46, 0x46, 0x46,
  0xD5, 0xD9, 0xDF, 0x74, 0x7B, 0x89, 0xF3, 0xBE, 0xC0, 0x3B, 0x79, 0x64, 0x7B, 0x82, 0x91, 0xAD,
  0x7B, 0x88, 0xD8, 0x3D, 0x42, 0xE5, 0xA6, 0x4C, 0xE7, 0x7E, 0x81, 0x2B, 0x31, 0x3F, 0x20, 0x40,
  0x40, 0xB8, 0xBB, 0xC4, 0x2B, 0x32, 0x40, 0xEF, 0xA0, 0x30, 0x9A, 0xA3, 0xB4, 0xD6, 0x26, 0x2B,
  0xE6, 0xE8, 0xEE, 0x00, 0x00, 0x00, 0x4B, 0xC2, 0x89, 0xD3, 0x8A, 0x1F, 0xFE, 0xFE, 0xFE, 0xEA,
  0x9B, 0x2C, 0xD6, 0x8C, 0x21, 0xD9, 0xA1, 0x52, 0xED, 0xB2, 0x62, 0x3D, 0x82, 0x68, 0x8D, 0x69,
  0x37, 0xD7, 0x92, 0x31, 0x34, 0x5C, 0x55, 0x32, 0x31, 0x3E, 0xB1, 0x28, 0x2F, 0x33, 0x48, 0x4D,
  0x2B, 0x32, 0x40, 0x71, 0x2D, 0x37, 0x90, 0x2A, 0x33, 0xF7, 0xD9, 0xDA, 0xD8, 0x34, 0x39, 0x2B,
  0x32, 0x40, 0xDB, 0x47, 0x4B, 0x49, 0xB7, 0x83, 0x2B, 0x32, 0x40, 0x36, 0x66, 0x5A, 0xF4, 0xC7,
  0xC8, 0xE3, 0x67, 0x6B, 0xEE, 0xA8, 0xAA, 0x58, 0x2E, 0x3A, 0x2B, 0x32, 0x40, 0x92, 0x9A, 0xA9,
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
  0x4D, 0xF9, 0xF7, 0x8A, 0xEB, 0xD1, 0x50, 0x22, 0xF4, 0x84, 0x4F, 0x9E, 0x49, 0x69, 0xB5, 0x75,
  0x5D, 0x7B, 0x04, 0x03, 0x7A, 0xAE, 0xDD, 0x08, 0xED, 0xF2, 0xAF, 0x8D, 0x5D, 0xE2, 0xF4, 0xF5,
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
};
const size_t favicon_png_len = 2017;
