Richard-V31/16_Store_Enrouleur/StoreEnrouleur_JGB37_DRV8876/arduino_secrets.h

#pragma once
#include <Arduino.h>

#define SECRET_SSID     "NomDeVotreBox"
#define SECRET_PASS     "MotDePasseDeVotreBox"

// Mode AP secours  http://192.168.5.1
#define SECRET_AP_SSID  "Store-ESP32"   // Réseau de secours créé par la carte
#define SECRET_AP_PASS  "Mot de Passe"     // 8 caractères minimum

//Mode OTA
#define SECRET_OTA_PASS "Mot de Passe"
