Richard-V31/16_Store_Enrouleur/(commit log)

2026-10-10 Modify Wi-Fi credentials and add fallback AP settings
    Updated Wi-Fi and fallback AP credentials in arduino_secrets.h.
2026-10-11 Add OTA password definition to arduino_secrets.h
2026-10-11 Add OTA password definition to arduino_secrets.h
    Added OTA password definition for over-the-air updates.
2026-10-11 Update driver note for dual motor setup
2026-10-11 Update driver requirement for ULN2803 in Readme
2026-10-11 Update driver description in Readme.md
